davidcoates/keyboards/hardware/orders/plates/top_plate.dxf

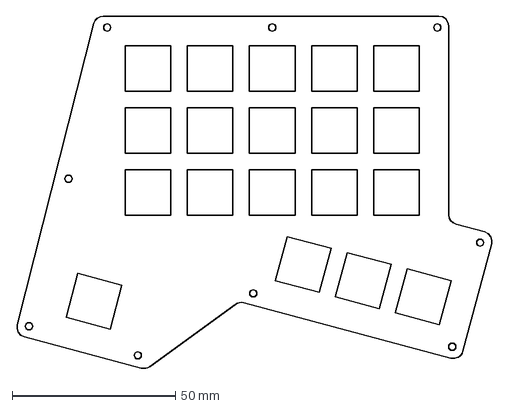
[picture p2: CAD file, 2026-09-22]
hardware/orders/plates/top_plate.dxf
146.2 x 108.2 mm
