davidcoates/keyboards/hardware/orders/plates/bottom_plate.dxf

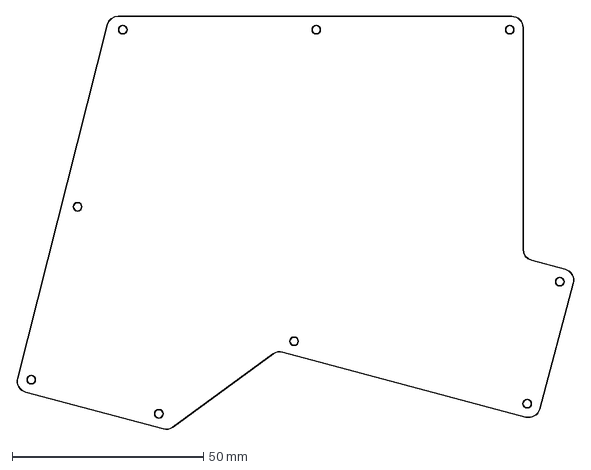
[picture p3: CAD file, 2026-09-22]
hardware/orders/plates/bottom_plate.dxf
146.2 x 108.2 mm
