davidcoates/keyboards/hardware/kicad/shannon.kicad_pcb

## KiCad design hardware/kicad/shannon.kicad_pcb (2026-09-22)

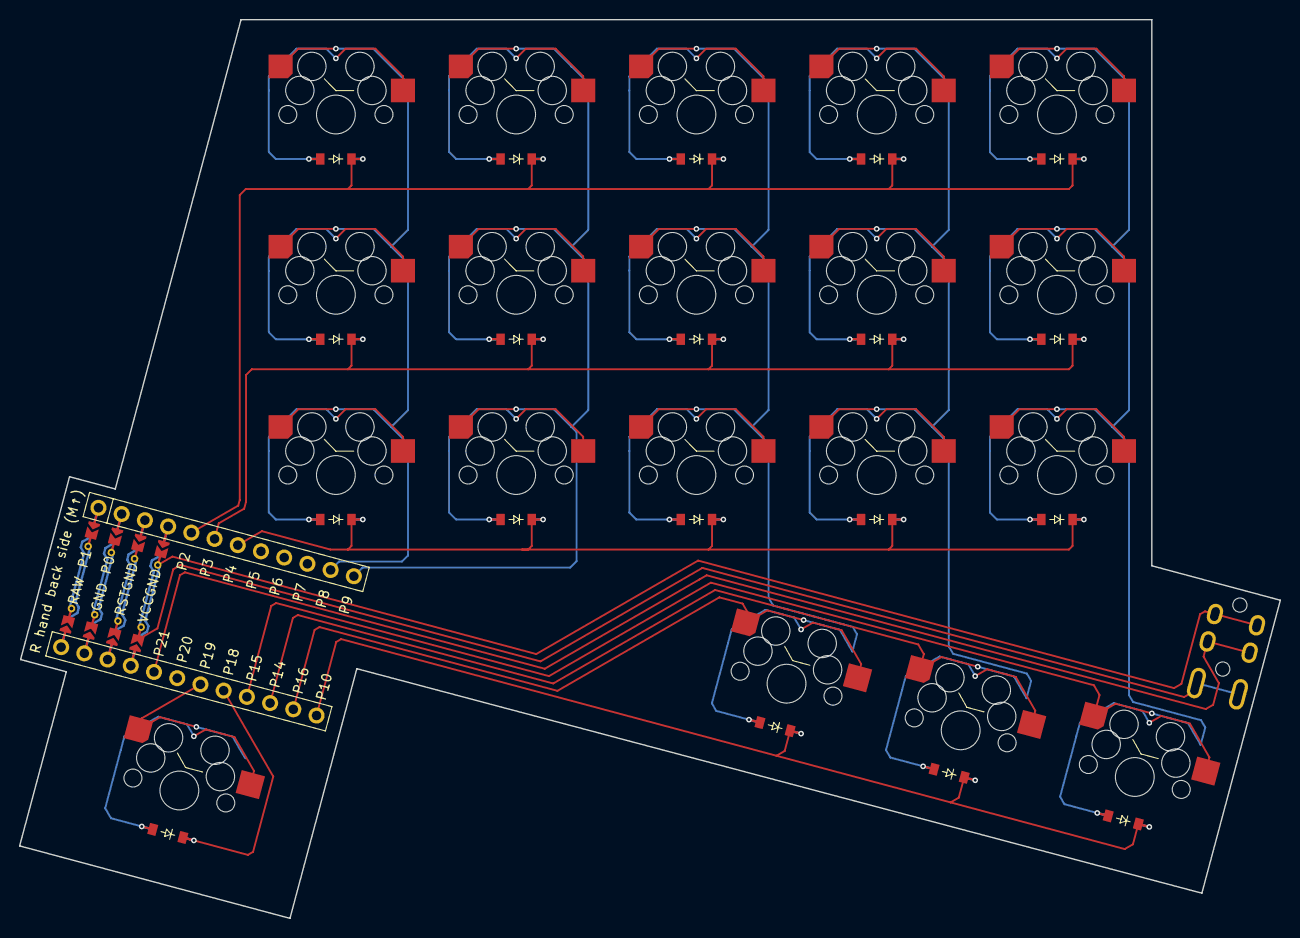
[picture p4: board shannon.kicad_pcb from above]

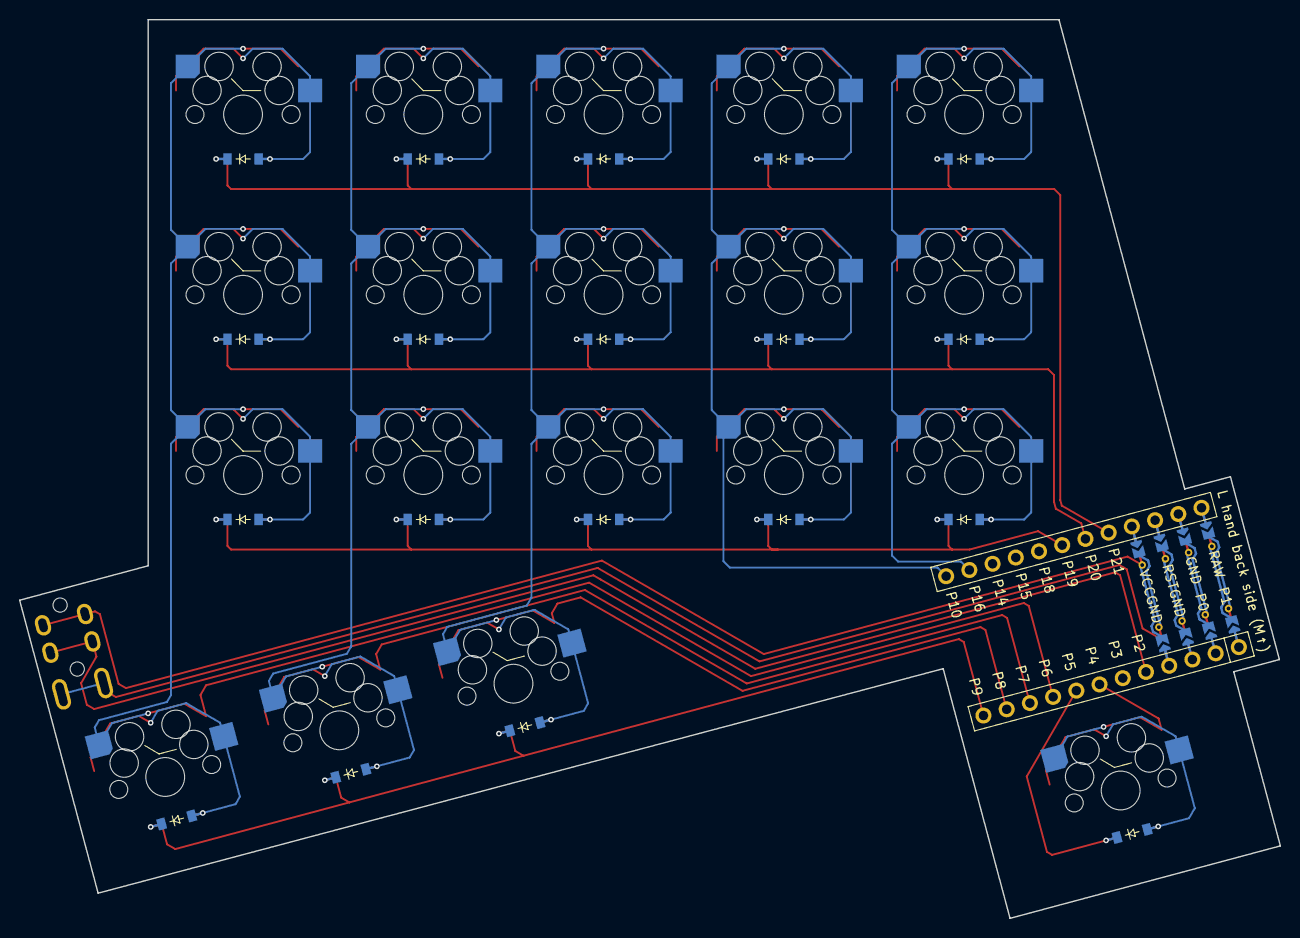
[picture p5: board shannon.kicad_pcb from below]

Board: 2 copper layers, 133.2 x 95.0 mm, 40 parts (19 on the bottom side), 33 nets.

Parts:
D1, D2, D3, D4, D5, D6, D7, D8, D9, D10, D11, D12, D13, D14, D15, D16, D17, D18, D19: diode_tht_sod123
MCU1: mcu_nice_nano
S1, S2, S3, S4, S5, S6, S7, S8, S9, S10, S11, S12, S13, S14, S15, S16, S17, S18, S19: switch_mx
TRRS1: trrs_pj320a (reversible, symmetric)

Connections:
GND: MCU1.103, MCU1.104, MCU1.123, TRRS1.2
P2: D3.1, D6.1, D9.1, D12.1, D15.1, MCU1.5
P3: D2.1, D5.1, D8.1, D11.1, D14.1, MCU1.6
P4: D1.1, D4.1, D7.1, D10.1, D13.1, MCU1.7
P8: MCU1.11, S1.2, S2.2, S3.2
P9: MCU1.12, S4.2, S5.2, S6.2
P10: D16.1, D17.1, D18.1, MCU1.13
P14: MCU1.15, S10.2, S11.2, S12.2, S17.2
P15: MCU1.16, S13.2, S14.2, S15.2, S18.2
P16: MCU1.14, S7.2, S8.2, S9.2, S16.2
P18: D19.1, MCU1.17
P19: MCU1.18, S19.2
P21: MCU1.20, TRRS1.3
VCC: MCU1.121, TRRS1.4
center_default: D17.2, S17.1
default_default: D19.2, S19.1
index_bottom: D10.2, S10.1
index_home: D11.2, S11.1
index_top: D12.2, S12.1
inner_bottom: D13.2, S13.1
inner_default: D18.2, S18.1
inner_home: D14.2, S14.1
inner_top: D15.2, S15.1
middle_bottom: D7.2, S7.1
middle_home: D8.2, S8.1
middle_top: D9.2, S9.1
outer_default: D16.2, S16.1
pinky_bottom: D1.2, S1.1
pinky_home: D2.2, S2.1
pinky_top: D3.2, S3.1
ring_bottom: D4.2, S4.1
ring_home: D5.2, S5.1
ring_top: D6.2, S6.1
