davidcoates/keyboards/(commit log)

2026-07-24 switch to QMK external-userspace
2026-09-18 relayout shannon symbols
2026-09-22 remove nyquist and plank
    [BOM.csv, bottom_plate.dxf, shannon.kicad_pcb, shannon.kicad_sch, top_plate.dxf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]
2026-09-23 rotate right hand symbols to avoid same finger ./
